HackerspaceBielefeld/Etherbridge/HW-Doc/Etherbridge_PCB.pdf

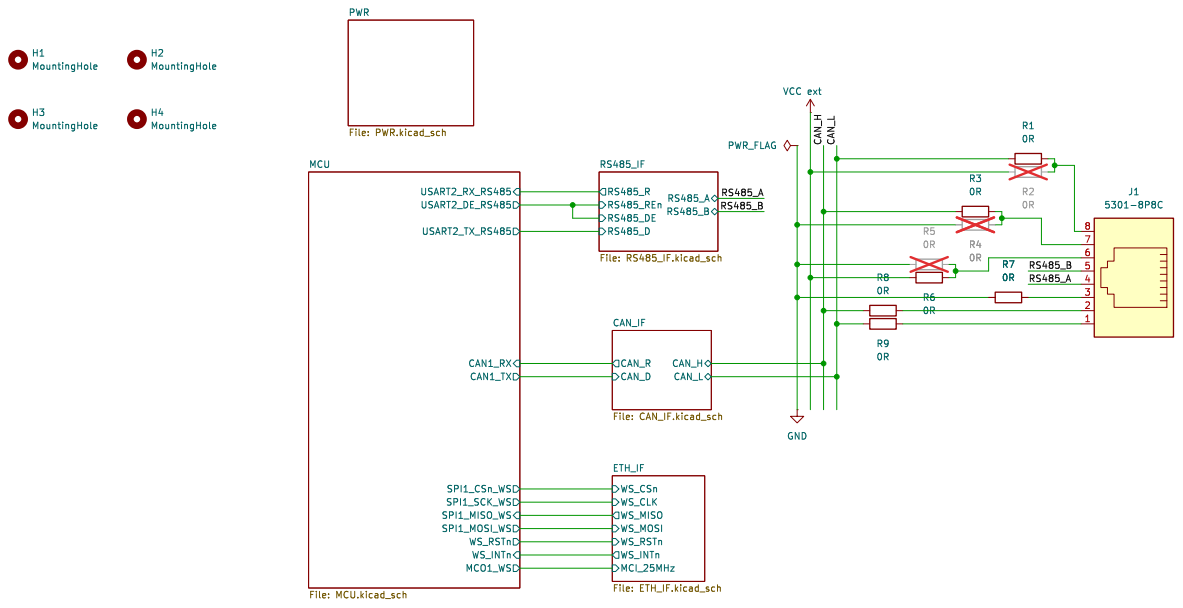
[picture p2: page 1]

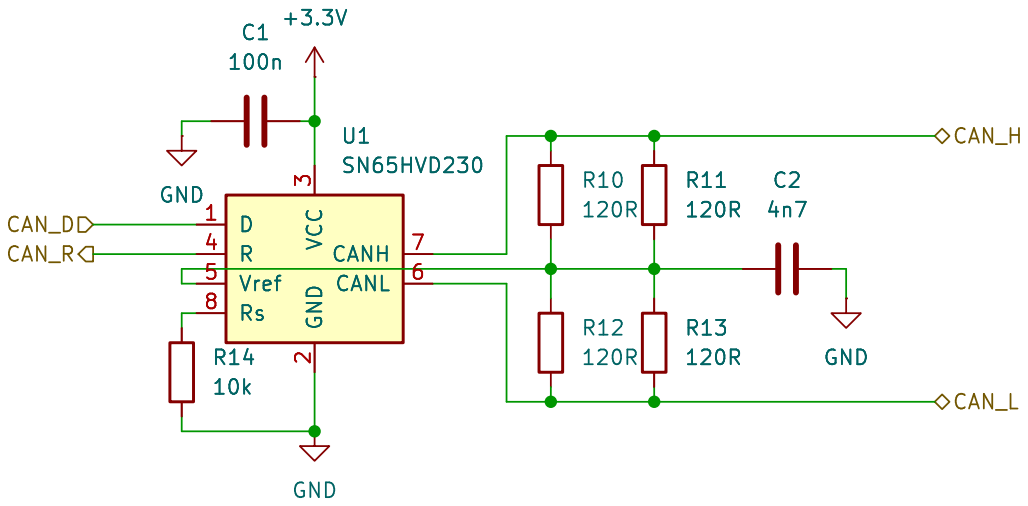
[picture p3: page 2]

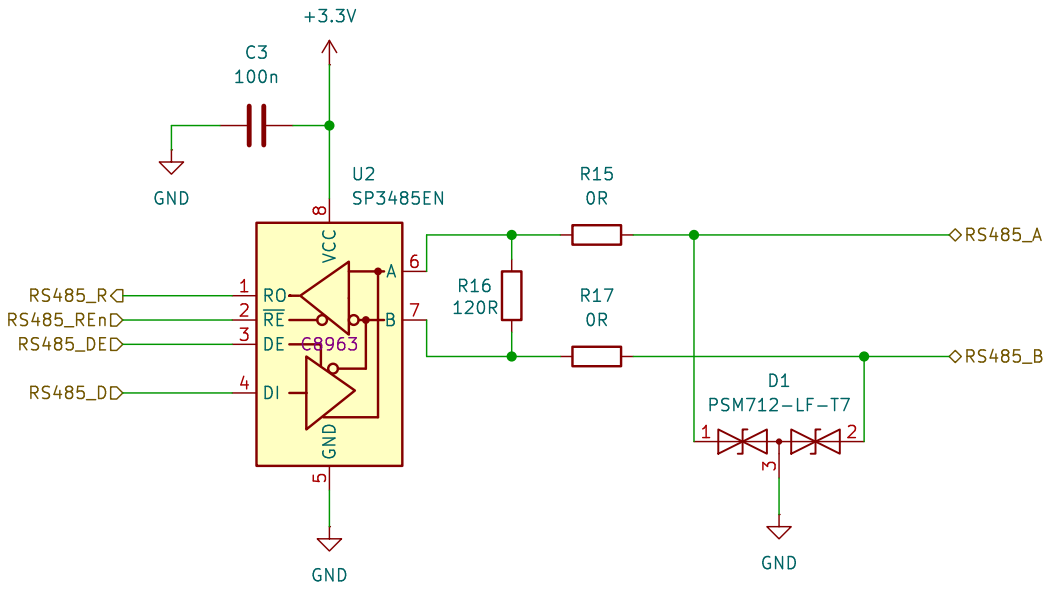
[picture p4: page 3]

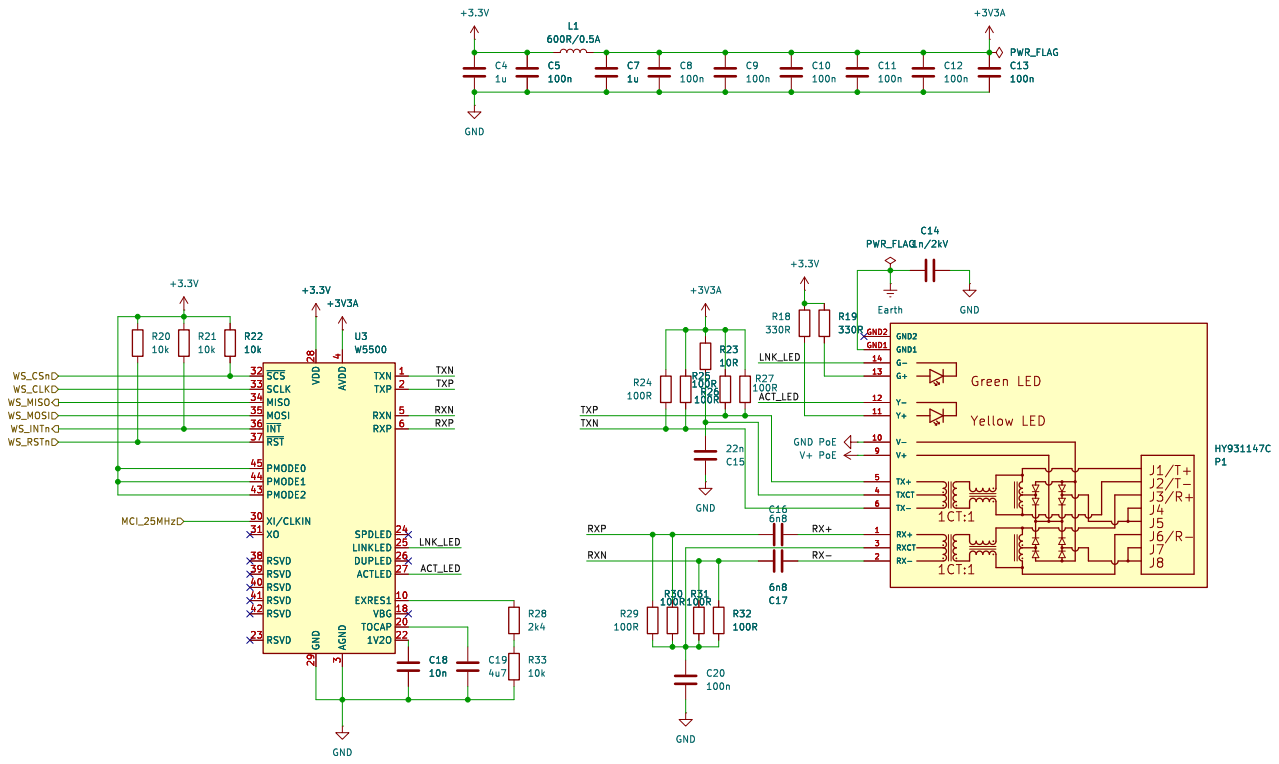
[picture p5: page 4]

3 TXN 1 TXP 2 RXN 5 RXP 6 SPDLED 24

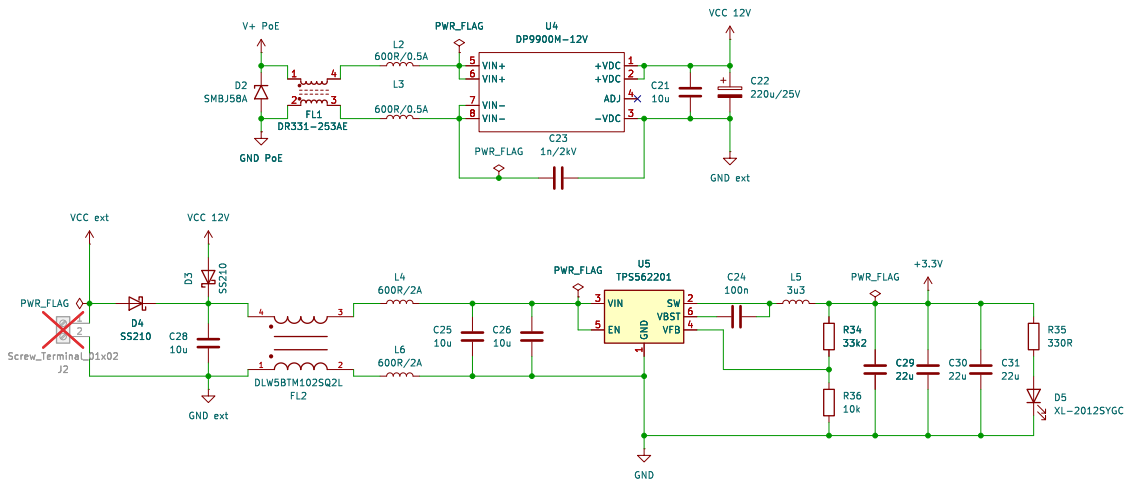
[picture p6: page 5]

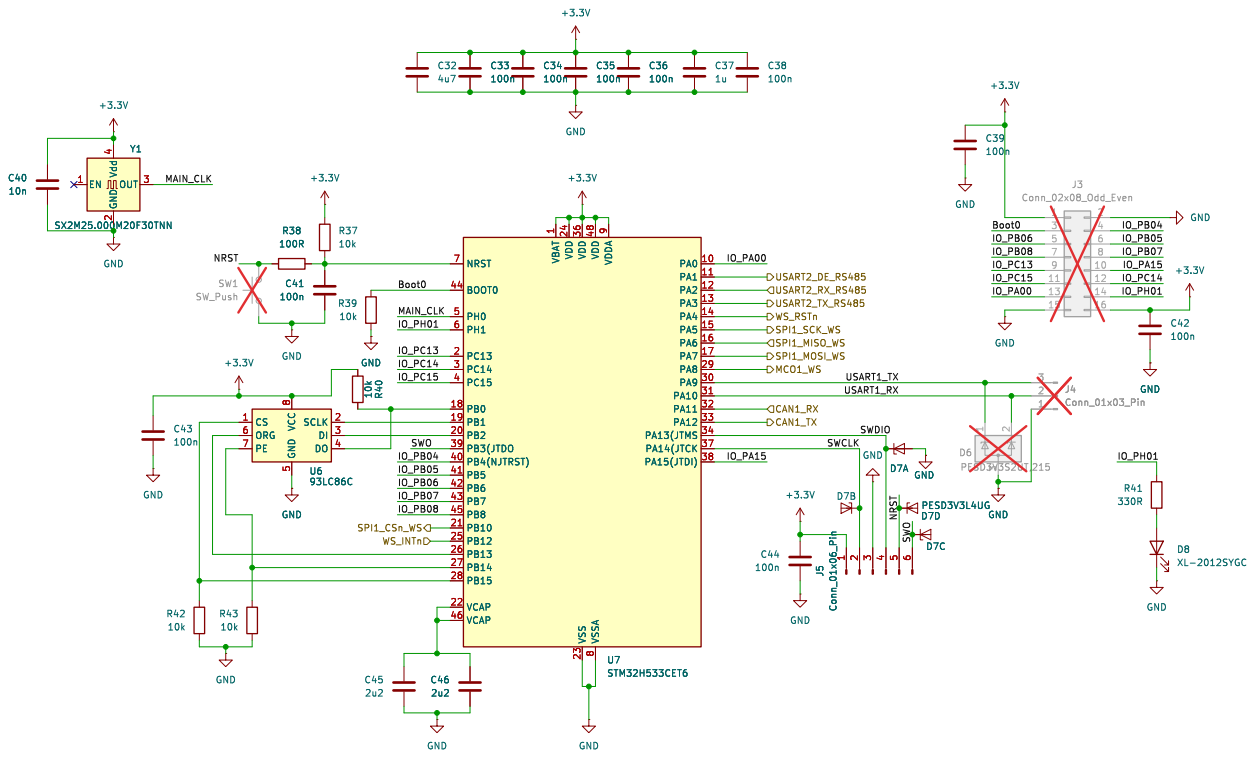
[picture p7: page 6]

1 VDD 24 VDD 36 VSS 23 VDD 48 VSSA
