HackerspaceBielefeld/Etherbridge/Inc/SysTick.h

/** 
* @file   SysTick.h
* @brief  Konfiguriert den Systick und aktiviert dessen Interrupt.
* @see    SysTick.c
*  
* @author Fki
* @date   22.02.2018
*
* @version 0.1 
* Initiale Version.
*/

#ifndef SYSTICK_H
#define SYSTICK_H

/* C-Style Block öffnen für C++ */
#ifdef __cplusplus
extern "C" {
#endif

/*******************************************************************************
*     INCLUDED FILES
*******************************************************************************/

#include <stdbool.h>
#include <stdint.h>

/*******************************************************************************
*     DEFINITIONS
*******************************************************************************/

/*******************************************************************************
*     PUBLIC TYPES
*******************************************************************************/
 
/*******************************************************************************
*     PUBLIC DATA
*******************************************************************************/

extern volatile bool SysTick_msTick;

/*******************************************************************************
*     PUBLIC FUNCTION PROTOTYPES
*******************************************************************************/

void SysTick_Init(void);
void SysTick_Handler(void);

uint32_t SysTick_GetMillis(void);
uint16_t SysTick_GetRandom(void);

/*******************************************************************************
*     END OF FILE
*******************************************************************************/

/* C-Style Block schließen */
#ifdef __cplusplus
}
#endif

#endif //SYSTICK_H
