HackerspaceBielefeld/Etherbridge/Inc/Timer.h

/** 
* @file   Timer.h
* @brief  Software-Timer.
* @see    Timer.c
*  
* @author Fki
*
* @version 0.1 - 13.01.2021
*/

#ifndef SW_TIMER_H
#define SW_TIMER_H

/*******************************************************************************
*     INCLUDED FILES
*******************************************************************************/

#include <stdbool.h>
#include <stdint.h>

/*******************************************************************************
*     DEFINITIONS
*******************************************************************************/

/*******************************************************************************
*     PUBLIC TYPES
*******************************************************************************/

class Timer {
private:
  uint32_t timestampLastHitMs;
  uint32_t sleepTimeMs;
public:
  bool isOver();
  void sleep(uint32_t sleepTimeMs);
  void delay(uint32_t sleepTime);
};


/*******************************************************************************
*     END OF FILE
*******************************************************************************/

#endif //TIMER_H
