HackerspaceBielefeld/Etherbridge/(commit log)

2025-05-19 Added datasheets and schematics.
2025-05-21 Pinout table added and pinout table in README.md updated.
    [MCU Pinout LQFP48.xlsx]
2025-05-21 Added CMSIS. Added clock setup code for PLL1, used for MCU core and busses. Added code for enabling the peripherials used by Etherbridge. Added GPIO initialsation code and pinout config table.
    [MCU Pinout LQFP48.xlsx]
2025-05-22 Added MCO1 config to BoardConfig.hpp. Added SysTick. Added MCO1 and Systick init to Board.cpp.
2025-05-27 Added writeBitField-method to BitsAndFields.hpp. Added test, too. Added some configuration to BoardConfig.hpp, Board.cpp and main.cpp for testing SPI. Added SPI driver and FastIo driver to repository.
2025-06-02 Added RS485 driver. Modified main for test with echo.
2025-06-11 Modbus bridge software porting finished, basic ModbusTCP to RTU translation is working.
    Currently, IP and MAC are fixed, Config webpage isn't working and config EEPROM still needs to be implemented.
    [Board.cpp, Board.hpp, BoardConfig.hpp, BoardPins.hpp, MicroTimer.cpp, MicroTimer.hpp, ModbusRTU.cpp, ModbusRTU.h]
2025-06-25 SPI driver tested.
2025-07-18 Removed webserver code. User LED switches on when IP address is provided by DHCP server. Etherbridge waites infinitely long for an IP address.
2025-07-19 Basic firmware for Etherbridge with Modbus TCP to Modbus RTU conversion. 9600 Baud, IP address via DHCP only.
    [MCU Pinout LQFP48.xlsx]
2025-07-26 Changed clock configuration for SPI to match specification.
